arn-c0de/AD8232-EMG/(commit log)

2026-05-09 Add live GUI with calibration wizard, threshold drag, REST API
    - GUI: tkinter + matplotlib, real-time raw/RMS plots
    - GUI: calibration wizard (relaxed → tense → auto threshold)
    - GUI: draggable threshold line, manual input, reset button
    - API: threaded HTTP server, calibration persistence (calibration.json)
    - API: exponential smoothing, hold time for tense detection
    - monitor.sh: --restart and --stop flags, auto-start API and GUI
    - flash.sh: fixed USB port detection, OTA with IP fallback
    - firmware: RMS window increased to 200ms for stable envelope
2026-05-09 Fix sampling, disconnect handling, LEAD_OFF rate, threshold validation
    - /record: collect only unique samples by timestamp, no duplicates
    - esp_reader: close socket and set connected=False on EOF/disconnect
    - LEAD_OFF: throttle to 10 Hz in firmware and API instead of every sample
    - /threshold: return 400 on invalid float input
    - firmware: add 20s WiFi timeout with reboot on failure
    - gui: log exceptions to stderr instead of silent swallow
    - gui: redraw canvas only when new data arrives (dirty flag)
    [emg_ota.ino]
2026-05-09 Improve signal quality: adaptive DC, HP filter, tighter RMS window
    - Adaptive DC tracker (α=0.0005) replaces fixed 2048 offset — tracks
    electrode drift and ADC bias without clipping valid signal
    - IIR high-pass at ~20 Hz before RMS removes motion artifacts and
    low-frequency noise; only muscle-band signal enters the RMS window
    - RMS window reduced 200ms → 100ms for faster muscle onset detection
    - Backend SMOOTH_ALPHA reduced 0.3 → 0.15; firmware now does the
    heavy filtering so API smoothing adds latency without benefit
    [config.h, emg_ota.ino]
2026-05-09 Add separate CodeQL scans for Python and Arduino
2026-05-09 feat: modular multi-channel EMG support (2 channels default)
    - firmware: ChannelPins struct array in config.h — one row per AD8232
    module; NUM_CHANNELS=2 with FCR (GPIO 34/16/17) and ED (GPIO 35/18/19)
    - firmware: Channel struct holds per-channel DC tracker, HP filter and
    RMS ring buffer; main loop iterates over CHANNELS[]
    - protocol: self-describing TCP stream — header #CH:n,labels on connect,
    packed CSV raw0,rms0,raw1,rms1,... per tick, LEAD_OFF:<idx> per channel
    - api: channel-indexed REST endpoints /channel/{id}/threshold|record|
    calibration; calibration.json stores per-channel thresholds; legacy
    single-channel cal files migrated automatically on load
    - gui: dynamic gridspe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
2026-05-09 fix: add root handler — GET / returns API info instead of 404
2026-05-09 feat: migrate to ESP32-C5 WROOM — pins, FQBN, core 3.3.8
2026-05-09 Clarify ESP32-C5 WROOM references in README
2026-05-09 fix: CH0 NaN — avoid GPIO 0 (BOOT pull-down), add ADC_11db attenuation, guard sqrt
    [config.h, emg_ota.ino]
2026-05-09 Fix multi-channel GUI plotting and board references
    [config.h]
2026-05-14 feat(gui): gesture recording UI, template management, CH1 history fix
    - Segmented THRESHOLD/GESTURE mode control replaces hidden toggle button
    - Gesture panel (visible in GESTURE mode): name entry, REC 3s button,
    countdown status, template list with per-item color accent and delete
    - GestureEngine: template persistence (gestures.json), delete, save/load
    - All-channels-below-threshold → RELAXED detection in GESTURE mode
    - Fix CH1 RMS showing only current value (no history): defensive padding
    of rms_lists prevents fallback to [live_rms]*WINDOW flat-line render
    - Channel title colored per-channel color for clear visual separation
